felixfisc/SolarSimulator_SOMAP/Result_Data/Spectral_Match/2024-6-5 SpMis rast Halog/1 SpMis rast Halog/about.txt

nd + LP780 on thor @ 35ms with factor *0.25 as used for main maximum of halogen lamp
rasterd with 9x9 points 1cm steps
measurement devices were centered on main maximum at start (X = 40 cm, Y = 40 cm)
