felixfisc/SolarSimulator_SOMAP/Result_Data/Spectral_Match/1 Halogen main + sidemax/Figure_1_halogen_mainmax_24mm_35ms.png

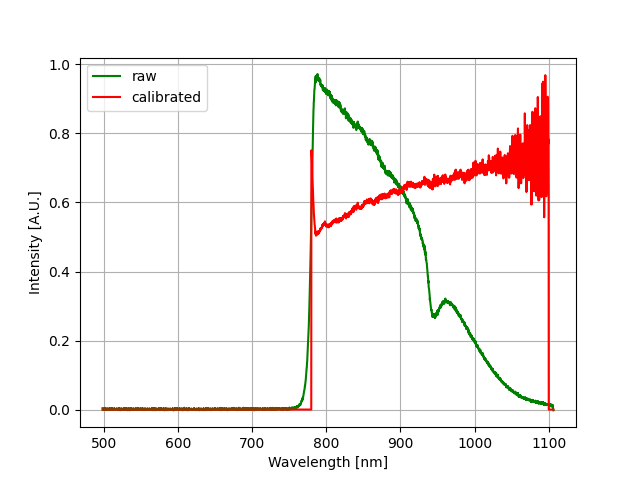
Result_Data/Spectral_Match/1 Halogen main + sidemax/Figure_1_halogen_mainmax_24mm_35ms.png
