felixfisc/SolarSimulator_SOMAP/PCBs_KiCad/Parts_KiCad/LIB_A6211GLJTR-T/A6211GLJTR-T/3D/A6211GLJTR-T.stp

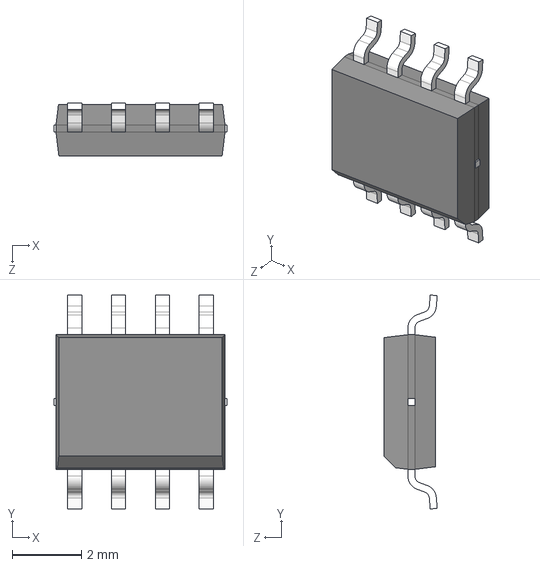
[picture p3: CAD file, 2024-07-03]
PCBs_KiCad/Parts_KiCad/LIB_A6211GLJTR-T/A6211GLJTR-T/3D/A6211GLJTR-T.stp
5.00 x 6.20 x 1.55 mm
