felixfisc/SolarSimulator_SOMAP/PCBs_KiCad/Parts_KiCad/LIB_B250A-13-F/B250A-13-F/3D/B250A-13-F.stp

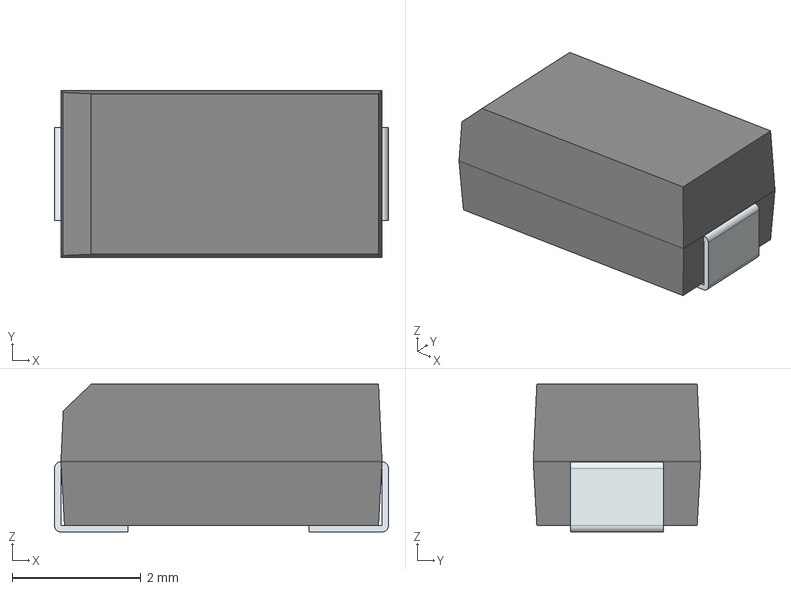
[picture p4: CAD file, 2024-07-03]
PCBs_KiCad/Parts_KiCad/LIB_B250A-13-F/B250A-13-F/3D/B250A-13-F.stp
5.20 x 2.60 x 2.30 mm
FilletPin1
FilletPin2
