felixfisc/SolarSimulator_SOMAP/PCBs_KiCad/Parts_KiCad/LIB_ERJ-U6SFR10V/ERJ-U6SFR10V/3D/ERJ-U6SFR10V.stp

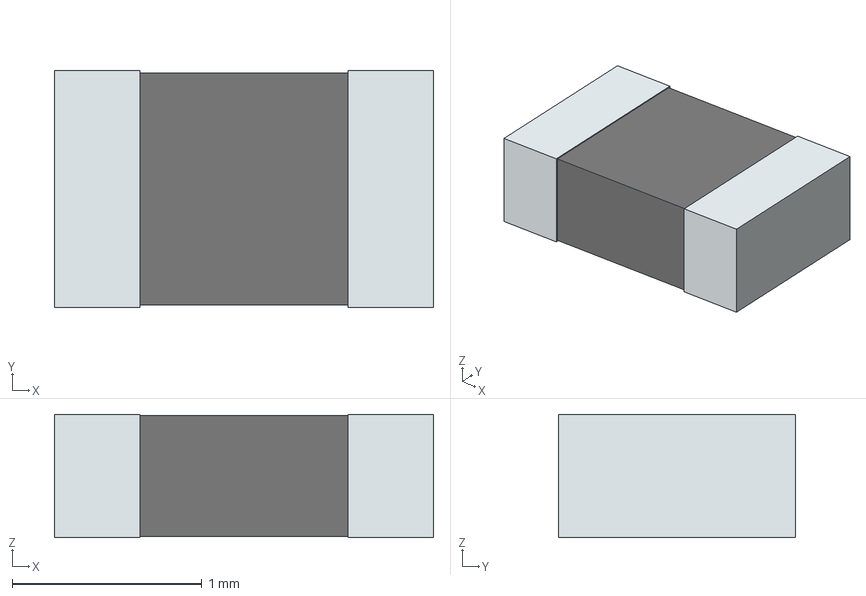
[picture p5: CAD file, 2024-07-03]
PCBs_KiCad/Parts_KiCad/LIB_ERJ-U6SFR10V/ERJ-U6SFR10V/3D/ERJ-U6SFR10V.stp
2.00 x 1.25 x 0.65 mm
term1
term2
