felixfisc/SolarSimulator_SOMAP/PCBs_KiCad/Parts_KiCad/LIB_SRR1210-680M/SRR1210-680M/3D/SRR1210-680M.stp

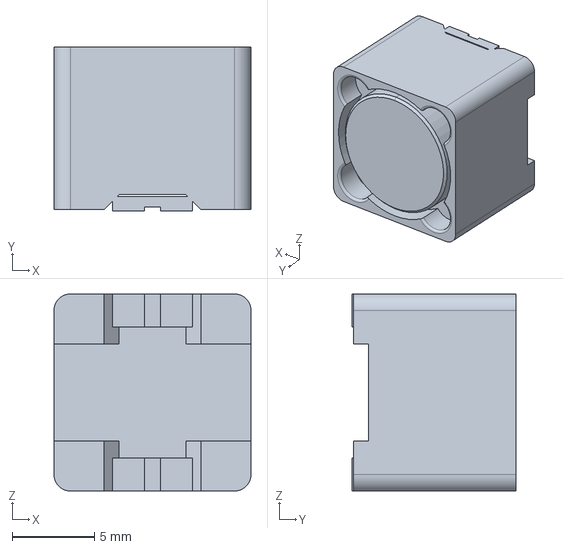
[picture p6: CAD file, 2024-07-03]
PCBs_KiCad/Parts_KiCad/LIB_SRR1210-680M/SRR1210-680M/3D/SRR1210-680M.stp
12.0 x 10.0 x 12.0 mm
