felixfisc/SolarSimulator_SOMAP/PCBs_KiCad/Parts_KiCad/43650-1021/3D/43650-1021.stp

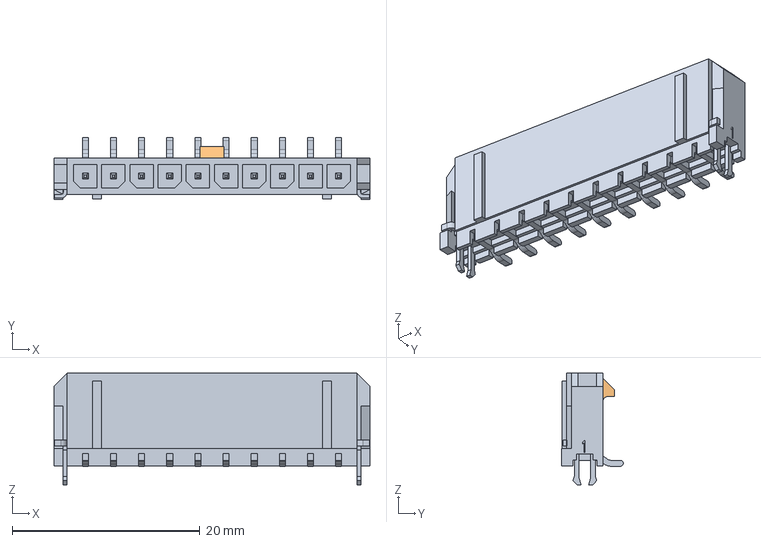
[picture p7: CAD file, 2024-07-03]
PCBs_KiCad/Parts_KiCad/43650-1021/3D/43650-1021.stp
33.7 x 6.57 x 11.9 mm
