felixfisc/SolarSimulator_SOMAP/PCBs_KiCad/Parts_KiCad/LIB_43650-0212/43650-0212/3D/43650-0212.stp

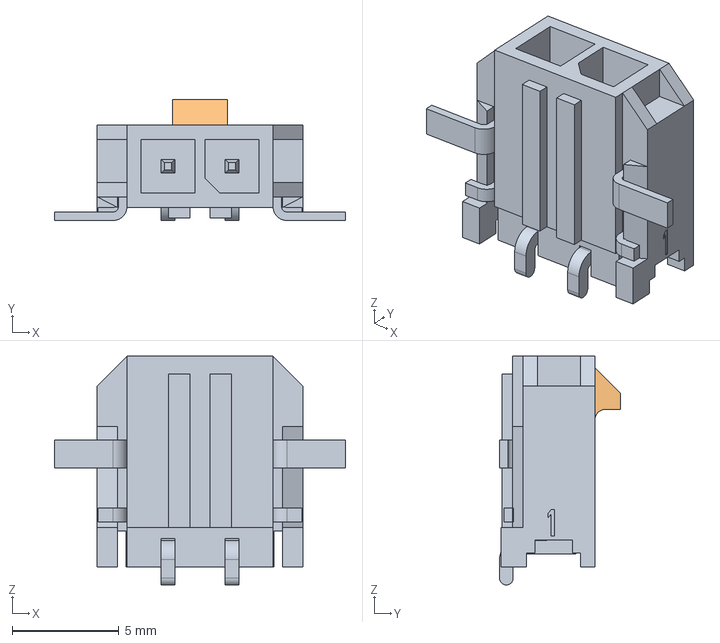
[picture p8: CAD file, 2024-07-03]
PCBs_KiCad/Parts_KiCad/LIB_43650-0212/43650-0212/3D/43650-0212.stp
13.7 x 5.67 x 10.7 mm
