felixfisc/SolarSimulator_SOMAP/PCBs_KiCad/Parts_KiCad/LIB_43650-0500/43650-0500/3D/43650-0500.stp

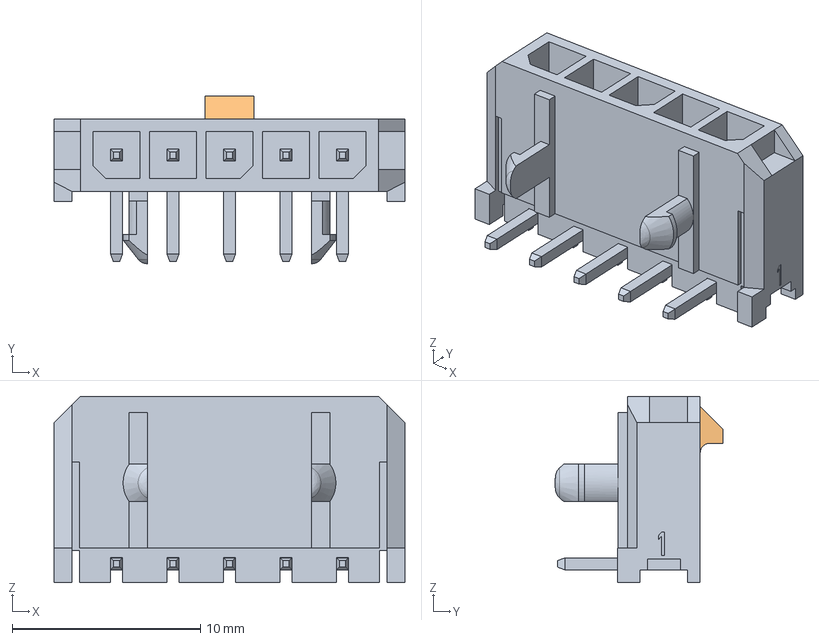
[picture p9: CAD file, 2024-07-03]
PCBs_KiCad/Parts_KiCad/LIB_43650-0500/43650-0500/3D/43650-0500.stp
18.6 x 8.91 x 9.90 mm
