felixfisc/SolarSimulator_SOMAP/PCBs_KiCad/Parts_KiCad/LIB_43650-0600/43650-0600/3D/43650-0600.stp

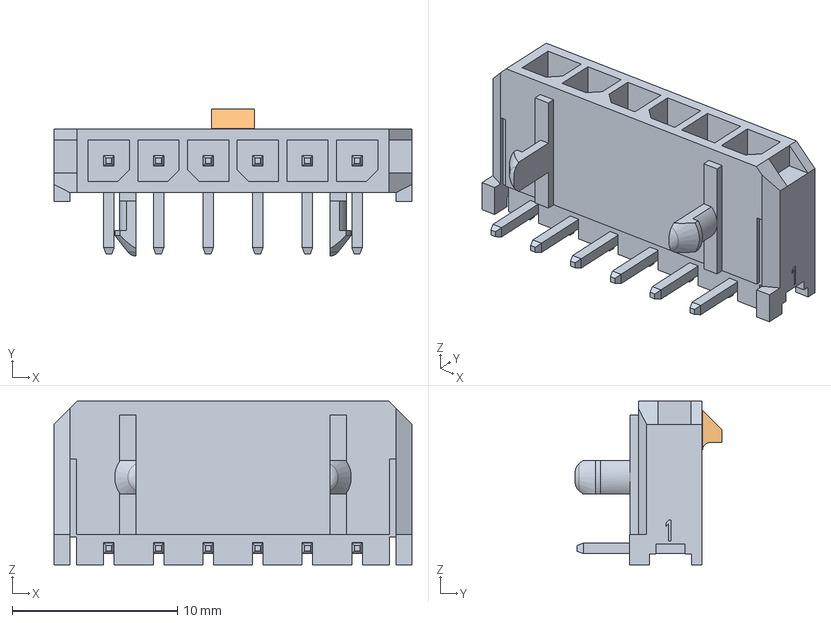
[picture p10: CAD file, 2024-07-03]
PCBs_KiCad/Parts_KiCad/LIB_43650-0600/43650-0600/3D/43650-0600.stp
21.6 x 8.90 x 9.90 mm
