felixfisc/SolarSimulator_SOMAP/PCBs_KiCad/Parts_KiCad/LIB_436501009/436501009/3D/436501009.stp

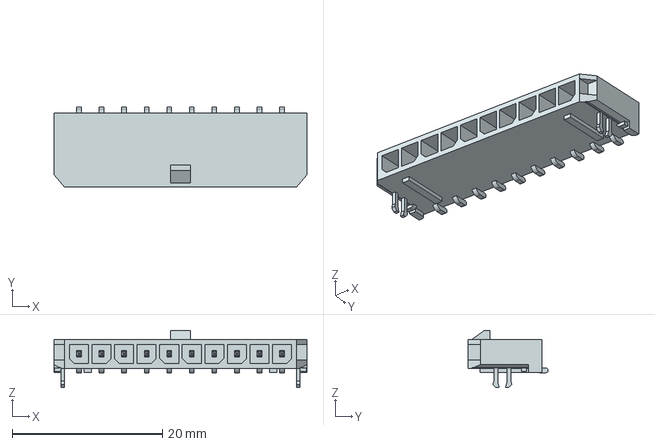
[picture p11: CAD file, 2024-07-03]
PCBs_KiCad/Parts_KiCad/LIB_436501009/436501009/3D/436501009.stp
33.7 x 10.7 x 7.60 mm
