felixfisc/SolarSimulator_SOMAP/PCBs_KiCad/Parts_KiCad/LIB_MP24833-AGN-Z/MP24833-AGN-Z/3D/MP24833-AGN-Z.stp

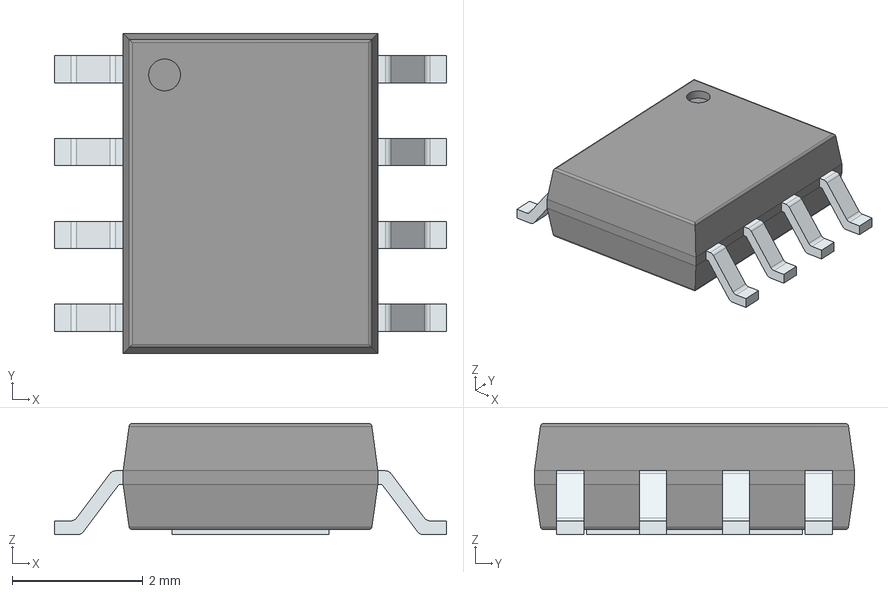
[picture p12: CAD file, 2024-07-03]
PCBs_KiCad/Parts_KiCad/LIB_MP24833-AGN-Z/MP24833-AGN-Z/3D/MP24833-AGN-Z.stp
6.00 x 4.90 x 1.70 mm
PinsArrayLR
ThermalPad
