felixfisc/SolarSimulator_SOMAP/(list of files, cad)

Other CAD files:
PCBs_KiCad/Parts_KiCad/43650-1021/Allegro/43650-10yy_212223.psm
PCBs_KiCad/Parts_KiCad/43650-1021/DEHDL/43650_1021/chips/chips.prt
PCBs_KiCad/Parts_KiCad/LIB_43650-0212/43650-0212/Allegro/43650-02_12,13,14_.psm
PCBs_KiCad/Parts_KiCad/LIB_43650-0212/43650-0212/DEHDL/43650_0212/chips/chips.prt
PCBs_KiCad/Parts_KiCad/LIB_43650-0500/43650-0500/Allegro/43650-05_00,01,02_.psm
PCBs_KiCad/Parts_KiCad/LIB_43650-0500/43650-0500/DEHDL/43650_0500/chips/chips.prt
PCBs_KiCad/Parts_KiCad/LIB_43650-0600/43650-0600/Allegro/43650-06_00,01,02_.psm
PCBs_KiCad/Parts_KiCad/LIB_43650-0600/43650-0600/DEHDL/43650_0600/chips/chips.prt
PCBs_KiCad/Parts_KiCad/LIB_436501009/436501009/Allegro/4365010yy_091011.psm
PCBs_KiCad/Parts_KiCad/LIB_436501009/436501009/DEHDL/436501009/chips/chips.prt
PCBs_KiCad/Parts_KiCad/LIB_A6211GLJTR-T/A6211GLJTR-T/Allegro/soic127p600x170-9n.psm
PCBs_KiCad/Parts_KiCad/LIB_A6211GLJTR-T/A6211GLJTR-T/DEHDL/a6211gljtr_t/chips/chips.prt
PCBs_KiCad/Parts_KiCad/LIB_B250A-13-F/B250A-13-F/Allegro/diom5226x230n.psm
PCBs_KiCad/Parts_KiCad/LIB_B250A-13-F/B250A-13-F/DEHDL/b250a_13_f/chips/chips.prt
PCBs_KiCad/Parts_KiCad/LIB_ERJ-U6SFR10V/ERJ-U6SFR10V/Allegro/resc2012x65n.psm
PCBs_KiCad/Parts_KiCad/LIB_ERJ-U6SFR10V/ERJ-U6SFR10V/DEHDL/erj_u6sfr10v/chips/chips.prt
PCBs_KiCad/Parts_KiCad/LIB_L1HX-5070200000000/L1HX-5070200000000/Allegro/l1hx5070200000000.psm
PCBs_KiCad/Parts_KiCad/LIB_L1HX-5070200000000/L1HX-5070200000000/DEHDL/l1hx_5070200000000/chips/chips.prt
PCBs_KiCad/Parts_KiCad/LIB_LTPL-C034UVH405/LTPL-C034UVH405/Allegro/ltplc034uvh405.psm
PCBs_KiCad/Parts_KiCad/LIB_LTPL-C034UVH405/LTPL-C034UVH405/DEHDL/ltpl_c034uvh405/chips/chips.prt
PCBs_KiCad/Parts_KiCad/LIB_MP24833-AGN-Z/MP24833-AGN-Z/Allegro/soic127p600x170-9n.psm
PCBs_KiCad/Parts_KiCad/LIB_MP24833-AGN-Z/MP24833-AGN-Z/DEHDL/mp24833_agn_z/chips/chips.prt
PCBs_KiCad/Parts_KiCad/LIB_SFH_4715A/SFH_4715A/Allegro/sfh-4715a.psm
PCBs_KiCad/Parts_KiCad/LIB_SFH_4715A/SFH_4715A/DEHDL/sfh_4715a/chips/chips.prt
PCBs_KiCad/Parts_KiCad/LIB_SRR1210-680M/SRR1210-680M/Allegro/srr1210.psm
PCBs_KiCad/Parts_KiCad/LIB_SRR1210-680M/SRR1210-680M/DEHDL/srr1210_680m/chips/chips.prt
PCBs_KiCad/Parts_KiCad/LIB_SST-10-FR-B130-J730/SST-10-FR-B130-J730/Allegro/sst10frb130j730.psm
PCBs_KiCad/Parts_KiCad/LIB_SST-10-FR-B130-J730/SST-10-FR-B130-J730/DEHDL/sst_10_fr_b130_j730/chips/chips.prt
PCBs_KiCad/Parts_KiCad/LIB_SST-20-WDS-A120-L2571/SST-20-WDS-A120-L2571/Allegro/sst20wdsa120l2571.psm
PCBs_KiCad/Parts_KiCad/LIB_SST-20-WDS-A120-L2571/SST-20-WDS-A120-L2571/DEHDL/sst_20_wds_a120_l2571/chips/chips.prt
