felixfisc/SolarSimulator_SOMAP/Result_Data/Non-uniformity/2024-5-22 SolSim/1 SolSim/about.txt

main meas is 12-40-35_15x15
row y = 120 mm row is without diffusor plate on x = 0 - x = 70 mm

additional meas is 13-10-59_15x1
is corrected row y = 120 from main meas, with diffusor plate

startup time of lamp more than 10 min (estimated)
