felixfisc/SolarSimulator_SOMAP/Result_Data/Non-uniformity/2024-5-22 SolSim/12-40-35_15x15_h40_HoMea.pdf

140

0

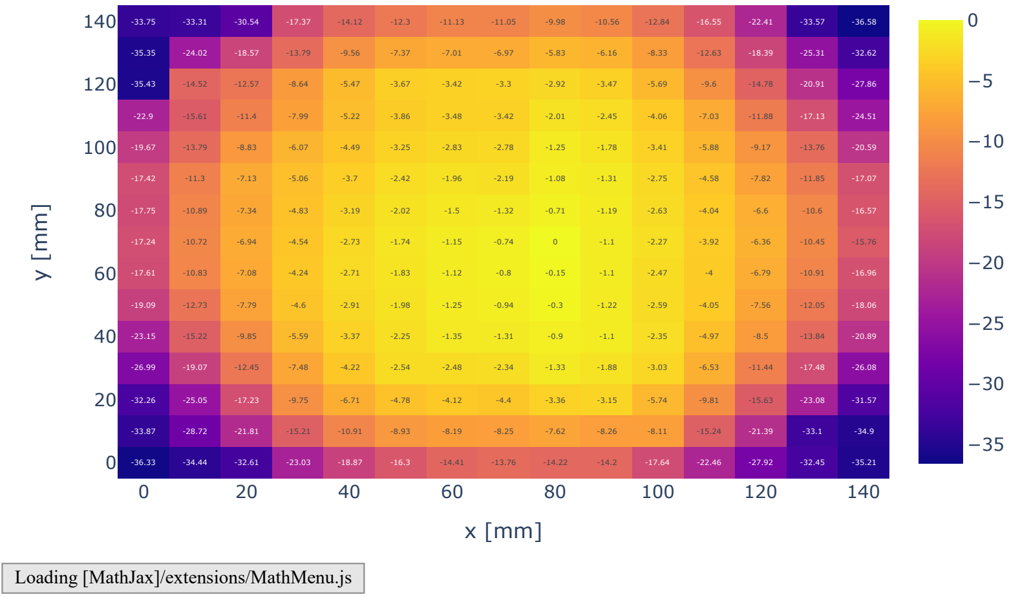
[picture p13: page 1]

-36.33 | -34.44 | -32.61 | -23.03 | -18.87 | -16.3 | -14.41 | -13.76 | -14.22 | -14.2 | -17.64 | -22.46 | -27.92 | -32.45 | -35.21
-33.87 | -28.72 | -21.81 | -15.21 | -10.91 | -8.93 | -8.19 | -8.25 | -7.62 | -8.26 | -8.11 | -15.24 | -21.39 | -33.1 | -34.9
-32.26 | -25.05 | -17.23 | -9.75 | -6.71 | -4.78 | -4.12 | -4.4 | -3.36 | -3.15 | -5.74 | -9.81 | -15.63 | -23.08 | -31.57
-26.99 | -19.07 | -12.45 | -7.48 | -4.22 | -2.54 | -2.48 | -2.34 | -1.33 | -1.88 | -3.03 | -6.53 | -11.44 | -17.48 | -26.08
-23.15 | -15.22 | -9.85 | -5.59 | -3.37 | -2.25 | -1.35 | -1.31 | -0.9 | -1.1 | -2.35 | -4.97 | -8.5 | -13.84 | -20.89
-19.09 | -12.73 | -7.79 | -4.6 | -2.91 | -1.98 | -1.25 | -0.94 | -0.3 | -1.22 | -2.59 | -4.05 | -7.56 | -12.05 | -18.06
-17.61 | -10.83 | -7.08 | -4.24 | -2.71 | -1.83 | -1.12 | -0.8 | -0.15 | -1.1 | -2.47 | -4 | -6.79 | -10.91 | -16.96
-17.24 | -10.72 | -6.94 | -4.54 | -2.73 | -1.74 | -1.15 | -0.74 | 0 | -1.1 | -2.27 | -3.92 | -6.36 | -10.45 | -15.76
-17.75 | -10.89 | -7.34 | -4.83 | -3.19 | -2.02 | -1.5 | -1.32 | -0.71 | -1.19 | -2.63 | -4.04 | -6.6 | -10.6 | -16.57
-17.42 | -11.3 | -7.13 | -5.06 | -3.7 | -2.42 | -1.96 | -2.19 | -1.08 | -1.31 | -2.75 | -4.58 | -7.82 | -11.85 | -17.07
-19.67 | -13.79 | -8.83 | -6.07 | -4.49 | -3.25 | -2.83 | -2.78 | -1.25 | -1.78 | -3.41 | -5.88 | -9.17 | -13.76 | -20.59
-22.9 | -15.61 | -11.4 | -7.99 | -5.22 | -3.86 | -3.48 | -3.42 | -2.01 | -2.45 | -4.06 | -7.03 | -11.88 | -17.13 | -24.51
-35.43 | -14.52 | -12.57 | -8.64 | -5.47 | -3.67 | -3.42 | -3.3 | -2.92 | -3.47 | -5.69 | -9.6 | -14.78 | -20.91 | -27.86
-35.35 | -24.02 | -18.57 | -13.79 | -9.56 | -7.37 | -7.01 | -6.97 | -5.83 | -6.16 | -8.33 | -12.63 | -18.39 | -25.31 | -32.62
-33.75 | -33.31 | -30.54 | -17.37 | -14.12 | -12.3 | -11.13 | -11.05 | -9.98 | -10.56 | -12.84 | -16.55 | -22.41 | -33.57 | -36.58
0 | 20 | 40 | 60 | 80 | 100 | 120 | 140

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
# x [mm]

# y [mm]

# Loading [MathJax]/extensions/MathMenu.js
