felixfisc/SolarSimulator_SOMAP/Result_Data/Non-uniformity/2024-5-23 halog/9-55-6_15x15_h24_HoMea.pdf

140

0

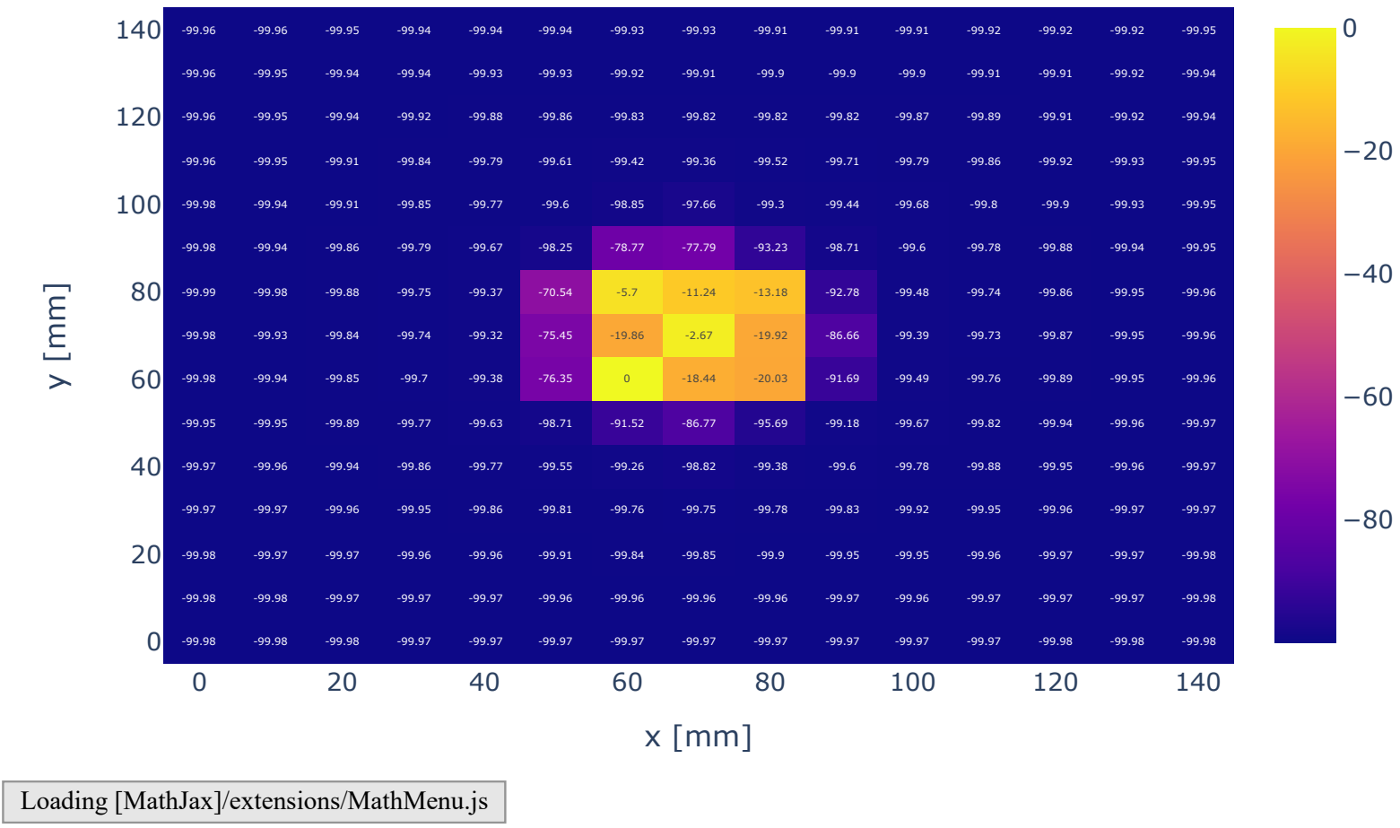
[picture p14: page 1]

-99.98 | -99.98 | -99.98 | -99.97 | -99.97 | -99.97 | -99.97 | -99.97 | -99.97 | -99.97 | -99.97 | -99.97 | -99.98 | -99.98 | -99.98
-99.98 | -99.98 | -99.97 | -99.97 | -99.97 | -99.96 | -99.96 | -99.96 | -99.96 | -99.97 | -99.96 | -99.97 | -99.97 | -99.97 | -99.98
-99.98 | -99.97 | -99.97 | -99.96 | -99.96 | -99.91 | -99.84 | -99.85 | -99.9 | -99.95 | -99.95 | -99.96 | -99.97 | -99.97 | -99.98
-99.97 | -99.97 | -99.96 | -99.95 | -99.86 | -99.81 | -99.76 | -99.75 | -99.78 | -99.83 | -99.92 | -99.95 | -99.96 | -99.97 | -99.97
-99.97 | -99.96 | -99.94 | -99.86 | -99.77 | -99.55 | -99.26 | -98.82 | -99.38 | -99.6 | -99.78 | -99.88 | -99.95 | -99.96 | -99.97
-99.95 | -99.95 | -99.89 | -99.77 | -99.63 | -98.71 | -91.52 | -86.77 | -95.69 | -99.18 | -99.67 | -99.82 | -99.94 | -99.96 | -99.97
-99.98 | -99.94 | -99.85 | -99.7 | -99.38 | -76.35 | 0 | -18.44 | -20.03 | -91.69 | -99.49 | -99.76 | -99.89 | -99.95 | -99.96
-99.98 | -99.93 | -99.84 | -99.74 | -99.32 | -75.45 | -19.86 | -2.67 | -19.92 | -86.66 | -99.39 | -99.73 | -99.87 | -99.95 | -99.96
-99.99 | -99.98 | -99.88 | -99.75 | -99.37 | -70.54 | -5.7 | -11.24 | -13.18 | -92.78 | -99.48 | -99.74 | -99.86 | -99.95 | -99.96
-99.98 | -99.94 | -99.86 | -99.79 | -99.67 | -98.25 | -78.77 | -77.79 | -93.23 | -98.71 | -99.6 | -99.78 | -99.88 | -99.94 | -99.95
-99.98 | -99.94 | -99.91 | -99.85 | -99.77 | -99.6 | -98.85 | -97.66 | -99.3 | -99.44 | -99.68 | -99.8 | -99.9 | -99.93 | -99.95
-99.96 | -99.95 | -99.91 | -99.84 | -99.79 | -99.61 | -99.42 | -99.36 | -99.52 | -99.71 | -99.79 | -99.86 | -99.92 | -99.93 | -99.95
-99.96 | -99.95 | -99.94 | -99.92 | -99.88 | -99.86 | -99.83 | -99.82 | -99.82 | -99.82 | -99.87 | -99.89 | -99.91 | -99.92 | -99.94
-99.96 | -99.95 | -99.94 | -99.94 | -99.93 | -99.93 | -99.92 | -99.91 | -99.9 | -99.9 | -99.9 | -99.91 | -99.91 | -99.92 | -99.94
-99.96 | -99.96 | -99.95 | -99.94 | -99.94 | -99.94 | -99.93 | -99.93 | -99.91 | -99.91 | -99.91 | -99.92 | -99.92 | -99.92 | -99.95
0 | 20 | 40 | 60 | 80 | 100 | 120 | 140

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
# x [mm]

# y [mm]

# Loading [MathJax]/extensions/MathMenu.js
