felixfisc/SolarSimulator_SOMAP/Result_Data/Temporal_Instability/2024-5-23 STI halog/10-51-32_for_10every0.1_TempMea.pdf

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

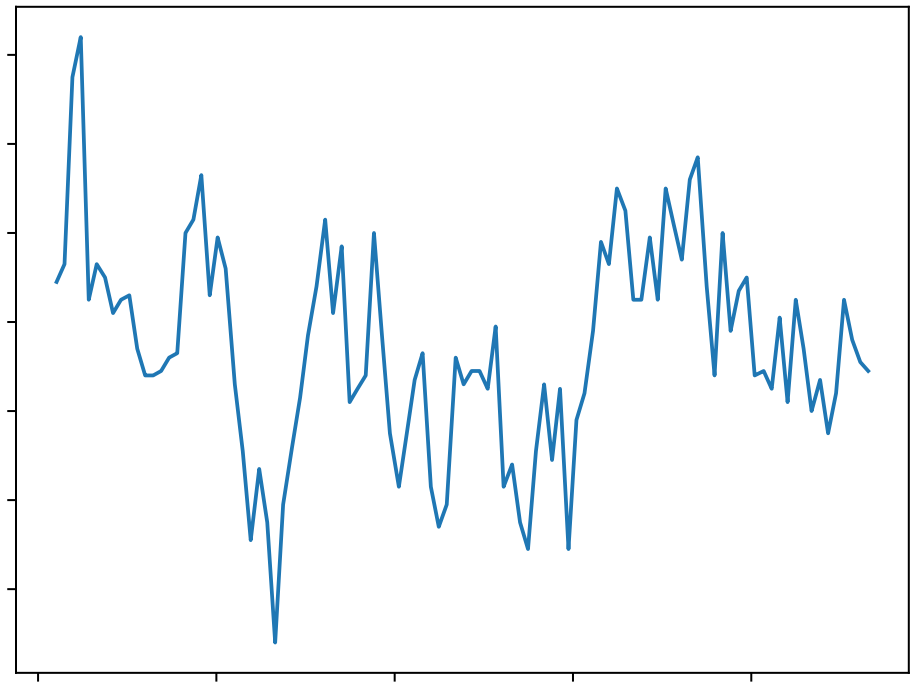
[picture p15: figure]
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
