felixfisc/SolarSimulator_SOMAP/Result_Data/Temporal_Instability/2024-6-4 STI solarsim/13-49-20_for_10every0.1_TempMea.pdf

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

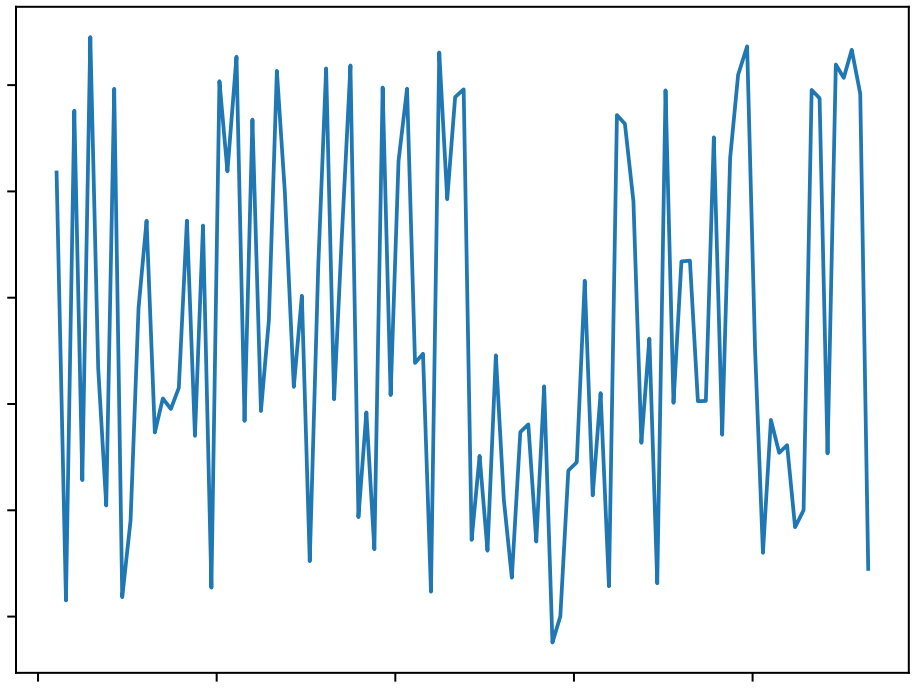
[picture p16: figure]
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
