felixfisc/SolarSimulator_SOMAP/Result_Data/Non-uniformity/2024-5-22 SolSim/12-40-35_15x15_h40_HoMea.csv

Time [s] | x [mm] | y [mm] | Voltage [V] | Current [A]
5.040374400035944 | 0.0 | 0.0 | 0.0 | 8.367719e-05
8.95728400000371 | 10.0 | 0.0 | 0.0 | 8.736299e-05
12.295825299981516 | 20.0 | 0.0 | 0.0 | 9.104525e-05
18.664744500012603 | 30.0 | 0.0 | 0.0 | 0.000112088
21.90893189999042 | 40.0 | 0.0 | 0.0 | 0.0001222832
25.817261299991515 | 50.0 | 0.0 | 0.0 | 0.0001289445
28.99539180001011 | 60.0 | 0.0 | 0.0 | 0.000134038
35.88003860000754 | 70.0 | 0.0 | 0.0 | 0.0001358273
45.687402300012764 | 80.0 | 0.0 | 0.0 | 0.0001345389
54.54699010000331 | 90.0 | 0.0 | 0.0 | 0.0001345979
58.23878950002836 | 100.0 | 0.0 | 0.0 | 0.0001254263
61.129991699999664 | 110.0 | 0.0 | 0.0 | 0.0001134476
64.229378500022 | 120.0 | 0.0 | 0.0 | 0.0001009521
68.35916789999465 | 130.0 | 0.0 | 0.0 | 9.13655e-05
76.70688660000451 | 140.0 | 0.0 | 0.0 | 8.584867e-05
95.10811400000239 | 0.0 | 10.0 | 0.0 | 8.849316e-05
98.49417940003332 | 10.0 | 10.0 | 0.0 | 9.920244e-05
105.84595779998926 | 20.0 | 10.0 | 0.0 | 0.0001149924
108.61865850002505 | 30.0 | 10.0 | 0.0 | 0.0001318502
111.6393875000067 | 40.0 | 10.0 | 0.0 | 0.0001439176
114.49788360000821 | 50.0 | 10.0 | 0.0 | 0.0001497747
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
