felixfisc/SolarSimulator_SOMAP/Result_Data/Non-uniformity/2024-5-23 halog/9-55-6_15x15_h24_HoMea.csv

Time [s] | x [mm] | y [mm] | Voltage [V] | Current [A]
43.01533120003296 | 0.0 | 0.0 | 0.0 | 3.446262e-07
48.76261670002714 | 10.0 | 0.0 | 0.0 | 3.825001e-07
52.681221200036816 | 20.0 | 0.0 | 0.0 | 4.252982e-07
57.439376800030004 | 30.0 | 0.0 | 0.0 | 4.680536e-07
61.81328330002725 | 40.0 | 0.0 | 0.0 | 5.12173e-07
66.13255620002747 | 50.0 | 0.0 | 0.0 | 5.467725e-07
70.4700315000373 | 60.0 | 0.0 | 0.0 | 5.861334e-07
75.19088950002333 | 70.0 | 0.0 | 0.0 | 5.854024e-07
79.34277500002645 | 80.0 | 0.0 | 0.0 | 5.722408e-07
83.96809770003892 | 90.0 | 0.0 | 0.0 | 5.511158e-07
88.15900139999576 | 100.0 | 0.0 | 0.0 | 5.123838e-07
93.96896070003277 | 110.0 | 0.0 | 0.0 | 4.785969e-07
97.49467779998668 | 120.0 | 0.0 | 0.0 | 4.401856e-07
103.35169330000645 | 130.0 | 0.0 | 0.0 | 4.163005e-07
110.20251909998478 | 140.0 | 0.0 | 0.0 | 3.568337e-07
141.12904760002857 | 0.0 | 10.0 | 0.0 | 3.748693e-07
148.30932810000377 | 10.0 | 10.0 | 0.0 | 4.29958e-07
151.95926040003542 | 20.0 | 10.0 | 0.0 | 4.843454e-07
155.76170860003913 | 30.0 | 10.0 | 0.0 | 5.414111e-07
165.12433140003122 | 40.0 | 10.0 | 0.0 | 5.923667e-07
169.29619990003994 | 50.0 | 10.0 | 0.0 | 6.49683e-07
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
