felixfisc/SolarSimulator_SOMAP/Result_Data/Temporal_Instability/2024-5-22 LTI/11-5-57_for_0.5every3600_TempMea.csv

Time [s] | Voltage [V] | Current [A]
0.20884410000871867 | 0.003007493 | 0.0
0.7145357999834232 | 0.001727329 | 0.0
1.2151527000241913 | 0.001724648 | 0.0
1.7148249999736436 | 0.001785547 | 0.0
2.3536745000164956 | 0.7128241 | 0.0
2.8461275000008754 | 1.321521 | 0.0
3.3430979999830015 | 1.30375 | 0.0
3.8469934000167996 | 1.292334 | 0.0
4.337669699976686 | 1.291703 | 0.0
4.840746800007764 | 1.28871 | 0.0
5.331471999990754 | 1.289961 | 0.0
5.834397099970374 | 1.276646 | 0.0
6.338158899976406 | 1.276508 | 0.0
6.841444400022738 | 1.279446 | 0.0
7.344704899995122 | 1.277549 | 0.0
7.852077000017744 | 1.269216 | 0.0
8.354479299974628 | 1.276977 | 0.0
8.858881600026507 | 1.277001 | 0.0
9.36242379999021 | 1.264407 | 0.0
9.895400399982464 | 1.269007 | 0.0
10.400409499998204 | 1.267611 | 0.0
10.903407500009052 | 1.268654 | 0.0
11.40666350000538 | 1.267681 | 0.0
11.9106899999897 | 1.261042 | 0.0
12.414683900016826 | 1.265332 | 0.0
12.9179213999887 | 1.261356 | 0.0
13.42090750002535 | 1.264682 | 0.0
13.924256199970841 | 1.260888 | 0.0
14.428355099982582 | 1.26293 | 0.0
14.93217270000605 | 1.267866 | 0.0
15.43622009997489 | 1.256485 | 0.0
15.939528900024015 | 1.265121 | 0.0
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
