felixfisc/SolarSimulator_SOMAP/Result_Data/Temporal_Instability/2024-5-22 LTI/14-30-18_for_0.5every3600_TempMea.csv

Time [s] | Voltage [V] | Current [A]
0.20634889998473227 | 0.003065498 | 0.0
0.7073240999598056 | 0.00132244 | 0.0
1.2066635999944992 | 0.001440792 | 0.0
1.8413532999693416 | 0.9999832 | 0.0
2.34269989997847 | 1.000039 | 0.0
2.838704299996607 | 1.001119 | 0.0
3.3408000000054017 | 1.000985 | 0.0
3.8425281000090763 | 1.00106 | 0.0
4.344129099976271 | 0.9999552 | 0.0
4.845726199971978 | 0.9999545 | 0.0
5.3473031999892555 | 1.000026 | 0.0
5.848486099974252 | 1.000095 | 0.0
6.349757599993609 | 1.000192 | 0.0
6.851336599967908 | 1.001035 | 0.0
7.352386999991722 | 1.001208 | 0.0
7.854756399989128 | 1.001464 | 0.0
8.3560976999579 | 1.000607 | 0.0
8.856850599986501 | 1.000966 | 0.0
9.35834579996299 | 1.0009 | 0.0
9.859497800003737 | 1.001567 | 0.0
10.360349599970505 | 1.001217 | 0.0
10.862149299995508 | 1.001827 | 0.0
11.363947400008328 | 1.00267 | 0.0
11.865419199981261 | 1.002285 | 0.0
12.366364299959969 | 1.00208 | 0.0
12.866383899992798 | 1.002043 | 0.0
13.367674099979922 | 1.002877 | 0.0
13.869355599978007 | 1.00334 | 0.0
14.37064169999212 | 1.002696 | 0.0
14.871948799991515 | 1.002808 | 0.0
15.373497299966402 | 1.00299 | 0.0
15.875216599961277 | 1.003255 | 0.0
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
