felixfisc/SolarSimulator_SOMAP/Result_Data/Temporal_Instability/2024-5-22 LTI/LTI calc.xlsx

Sheet: SolSim LTI
Time [s] | Voltage [V] | Current [A] | Max | Min | LTI [%] | Start second | Field
0.2088441 | 0.003007493 | 0 | 1.277001 | 1.046692 | 9.911335103 | 8.5 | 18
0.7145358 | 0.001727329 | 0 | 1.203569 | 1.046692 | 6.971502417 | 500 | 990
1.2151527 | 0.001724648 | 0 | 1.203569 | 1.046692 | 6.971502417 | 1000 | 1973
1.714825 | 0.001785547 | 0
2.3536745 | 0.7128241 | 0
2.8461275 | 1.321521 | 0
3.343098 | 1.30375 | 0
3.8469934 | 1.292334 | 0
4.3376697 | 1.291703 | 0
4.8407468 | 1.28871 | 0
5.331472 | 1.289961 | 0
5.8343971 | 1.276646 | 0
6.3381589 | 1.276508 | 0
6.8414444 | 1.279446 | 0
7.3447049 | 1.277549 | 0
7.852077 | 1.269216 | 0
8.3544793 | 1.276977 | 0
8.8588816 | 1.277001 | 0
9.3624238 | 1.264407 | 0
9.8954004 | 1.269007 | 0
10.4004095 | 1.267611 | 0
10.9034075 | 1.268654 | 0
11.4066635 | 1.267681 | 0
11.91069 | 1.261042 | 0
12.4146839 | 1.265332 | 0
12.9179214 | 1.261356 | 0
13.4209075 | 1.264682 | 0
13.9242562 | 1.260888 | 0
14.4283551 | 1.26293 | 0
14.9321727 | 1.267866 | 0
15.4362201 | 1.256485 | 0
15.9395289 | 1.265121 | 0
16.4648084 | 1.263889 | 0
16.9687886 | 1.254592 | 0
17.4735925 | 1.261419 | 0
17.9767794 | 1.257407 | 0
18.4801483 | 1.263244 | 0
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
