felixfisc/SolarSimulator_SOMAP/Result_Data/Temporal_Instability/2024-5-23 STI halog/10-51-32_for_10every0.1_TempMea.csv

Time [s] | Voltage [V] | Current [A]
0.20766349998302758 | 1.010089 | 0.0
0.2966718999668956 | 1.010093 | 0.0
0.3854058000142686 | 1.010135 | 0.0
0.4787699999869801 | 1.010144 | 0.0
0.5684926999965683 | 1.010085 | 0.0
0.6578878000145778 | 1.010093 | 0.0
0.751289599982556 | 1.01009 | 0.0
0.8409976999973878 | 1.010082 | 0.0
0.9305459999595769 | 1.010085 | 0.0
1.0235560999717563 | 1.010086 | 0.0
1.1124842999852262 | 1.010074 | 0.0
1.2012970999930985 | 1.010068 | 0.0
1.2908079999615438 | 1.010068 | 0.0
1.380336800008081 | 1.010069 | 0.0
1.4699872999917716 | 1.010072 | 0.0
1.5610102000064217 | 1.010073 | 0.0
1.6535248999716714 | 1.0101 | 0.0
1.7423499000142328 | 1.010103 | 0.0
1.8313868999830447 | 1.010113 | 0.0
1.925538300012704 | 1.010086 | 0.0
2.0142856999882497 | 1.010099 | 0.0
2.104157399968244 | 1.010092 | 0.0
2.206815399986226 | 1.010066 | 0.0
2.295910399989225 | 1.010051 | 0.0
2.3852410999825224 | 1.010031 | 0.0
2.4803532999940217 | 1.010047 | 0.0
2.570690599968657 | 1.010035 | 0.0
2.6595051999902353 | 1.010008 | 0.0
2.7487952999654226 | 1.010039 | 0.0
2.8498966000042856 | 1.010052 | 0.0
2.9389879999798723 | 1.010063 | 0.0
3.02745930000674 | 1.010077 | 0.0
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
