felixfisc/SolarSimulator_SOMAP/Result_Data/Temporal_Instability/2024-5-23 STI halog/10-51-32_for_10every0.1_TempMea_STI_halog_calc.csv

Time [s] | Voltage [V] | Current [A] | Temporal Instability (STI) [%]
0.20766349998302758 | 1.010089 | 0.0
0.2966718999668956 | 1.010093 | 0.0 | 0.000198001962194
0.3854058000142686 | 1.010135 | 0.0 | 0.002078973264409
0.4787699999869801 | 1.010144 | 0.0 | 0.000445483024866
0.5684926999965683 | 1.010085 | 0.0 | 0.002920460997245
0.6578878000145778 | 1.010093 | 0.0 | 0.000396004708496
0.751289599982556 | 1.01009 | 0.0 | 0.000148501398139
0.8409976999973878 | 1.010082 | 0.0 | 0.000396005884648
0.9305459999595769 | 1.010085 | 0.0 | 0.000148502574291
1.0235560999717563 | 1.010086 | 0.0 | 4.95007600910902E-05
1.1124842999852262 | 1.010074 | 0.0 | 0.000594012355463
1.2012970999930985 | 1.010068 | 0.0 | 0.00029700882413
1.2908079999615438 | 1.010068 | 0.0 | 0
1.380336800008081 | 1.010069 | 0.0 | 4.95015932156967E-05
1.4699872999917716 | 1.010072 | 0.0 | 0.000148504485577
1.5610102000064217 | 1.010073 | 0.0 | 4.9501397172863E-05
1.6535248999716714 | 1.0101 | 0.0 | 0.001336519199098
1.7423499000142328 | 1.010103 | 0.0 | 0.000148499927976
1.8313868999830447 | 1.010113 | 0.0 | 0.000494996574627
1.925538300012704 | 1.010086 | 0.0 | 0.00133650199807
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
