felixfisc/SolarSimulator_SOMAP/Result_Data/Temporal_Instability/2024-6-4 STI solarsim/13-49-20_for_10every0.1_TempMea.csv

Time [s] | Voltage [V] | Current [A]
0.20764300000155345 | 1.232356 | 0.0
0.31260570000085863 | 1.224303 | 0.0
0.4060978999987128 | 1.233519 | 0.0
0.4956455999999889 | 1.226567 | 0.0
0.5852602000013576 | 1.234904 | 0.0
0.6735164999990957 | 1.228676 | 0.0
0.7635942999986582 | 1.226089 | 0.0
0.8528194999998959 | 1.233931 | 0.0
0.942564199998742 | 1.224364 | 0.0
1.0359759999992093 | 1.225808 | 0.0
1.1252287999996042 | 1.229806 | 0.0
1.215241199999582 | 1.231449 | 0.0
1.3075538000011875 | 1.227464 | 0.0
1.397334099998261 | 1.228105 | 0.0
1.4869891999987885 | 1.227906 | 0.0
1.5759839999991527 | 1.228303 | 0.0
1.6669170999994094 | 1.231451 | 0.0
1.756802100000641 | 1.2274 | 0.0
1.8469500999999582 | 1.231358 | 0.0
1.9409677000003285 | 1.224544 | 0.0
2.030882200000633 | 1.234074 | 0.0
2.1203616999991937 | 1.232377 | 0.0
2.2218610999989323 | 1.234535 | 0.0
2.3120392999990145 | 1.227682 | 0.0
2.400383600001078 | 1.233351 | 0.0
2.4955673000004026 | 1.227867 | 0.0
2.5845907000002626 | 1.22958 | 0.0
2.673874699998123 | 1.234268 | 0.0
2.7630171999990125 | 1.231992 | 0.0
2.863593400001264 | 1.228321 | 0.0
2.953713200000493 | 1.230037 | 0.0
3.0419656999984 | 1.225043 | 0.0
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
