felixfisc/SolarSimulator_SOMAP/Result_Data/Temporal_Instability/2024-6-4 STI solarsim/13-49-20_for_10every0.1_TempMea_calc.csv

Time [s] | Voltage [V] | Current [A] | STI [%]
0.20764300000155345 | 1.232356 | 0.0
0.31260570000085863 | 1.224303 | 0.0 | 0.327802922587143
0.4060978999987128 | 1.233519 | 0.0 | 0.374966128547963
0.4956455999999889 | 1.226567 | 0.0 | 0.282591746792595
0.5852602000013576 | 1.234904 | 0.0 | 0.338699907494341
0.6735164999990957 | 1.228676 | 0.0 | 0.252802831651495
0.7635942999986582 | 1.226089 | 0.0 | 0.10538687002626
0.8528194999998959 | 1.233931 | 0.0 | 0.318777896114662
0.942564199998742 | 1.224364 | 0.0 | 0.389172170142309
1.0359759999992093 | 1.225808 | 0.0 | 0.058934638058063
1.1252287999996042 | 1.229806 | 0.0 | 0.162810604598278
1.215241199999582 | 1.231449 | 0.0 | 0.066754562205056
1.3075538000011875 | 1.227464 | 0.0 | 0.162063480895823
1.397334099998261 | 1.228105 | 0.0 | 0.026103929476219
1.4869891999987885 | 1.227906 | 0.0 | 0.008102569573184
1.5759839999991527 | 1.228303 | 0.0 | 0.016163119669376
1.6669170999994094 | 1.231451 | 0.0 | 0.127980277702573
1.756802100000641 | 1.2274 | 0.0 | 0.164751747869229
1.8469500999999582 | 1.231358 | 0.0 | 0.160975581980817
1.9409677000003285 | 1.224544 | 0.0 | 0.277454067792602
2.030882200000633 | 1.234074 | 0.0 | 0.387616132314976
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
