felixfisc/SolarSimulator_SOMAP/Result_Data/Temporal_Instability/2024-5-22 LTI/14-30-18_for_0.5every3600_TempMea.pdf

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

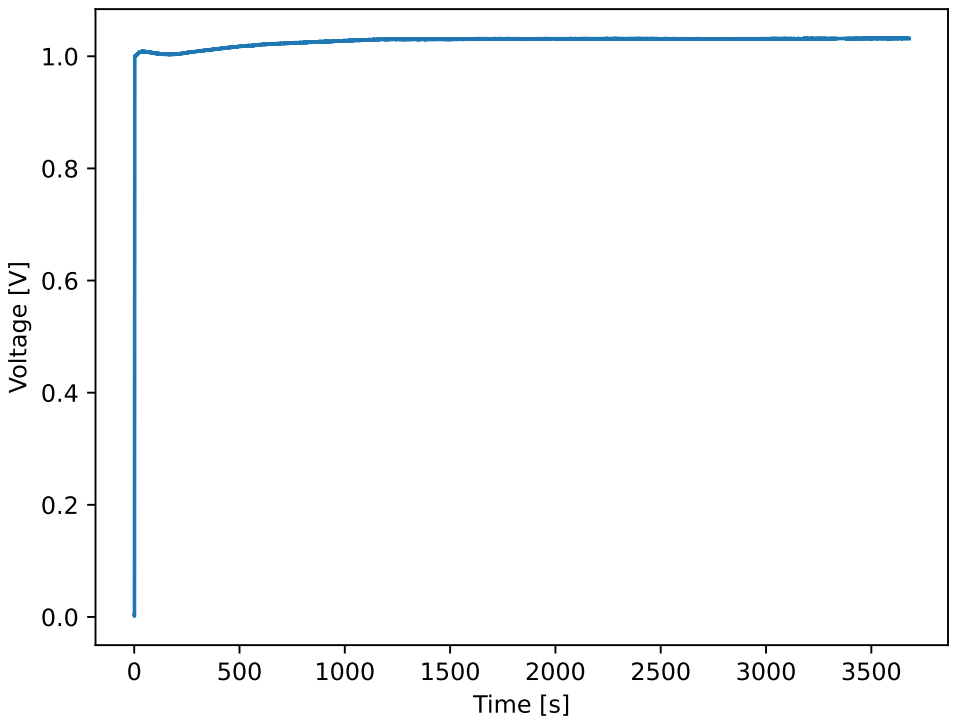
[picture p18: page 1]
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
