felixfisc/SolarSimulator_SOMAP/(list of files, drawings)

Other design files:
PCBs_KiCad/Parts_KiCad/LIB_A6211GLJTR-T/A6211GLJTR-T/Altium/A6211GLJTR-T.SchLib
PCBs_KiCad/Parts_KiCad/LIB_A6211GLJTR-T/A6211GLJTR-T/Altium/SOIC127P600X170-9N.PcbLib
PCBs_KiCad/Parts_KiCad/LIB_B250A-13-F/B250A-13-F/Altium/B250A-13-F.SchLib
PCBs_KiCad/Parts_KiCad/LIB_B250A-13-F/B250A-13-F/Altium/DIOM5226X230N.PcbLib
PCBs_KiCad/Parts_KiCad/LIB_ERJ-U6SFR10V/ERJ-U6SFR10V/Altium/ERJ-U6SFR10V.SchLib
PCBs_KiCad/Parts_KiCad/LIB_ERJ-U6SFR10V/ERJ-U6SFR10V/Altium/RESC2012X65N.PcbLib
PCBs_KiCad/Parts_KiCad/LIB_L1HX-5070200000000/L1HX-5070200000000/Altium/L1HX5070200000000.PcbLib
PCBs_KiCad/Parts_KiCad/LIB_L1HX-5070200000000/L1HX-5070200000000/Altium/L1HX-5070200000000.SchLib
PCBs_KiCad/Parts_KiCad/LIB_MP24833-AGN-Z/MP24833-AGN-Z/Altium/MP24833-AGN-Z.SchLib
PCBs_KiCad/Parts_KiCad/LIB_MP24833-AGN-Z/MP24833-AGN-Z/Altium/SOIC127P600X170-9N.PcbLib
PCBs_KiCad/Parts_KiCad/LIB_SST-10-FR-B130-J730/SST-10-FR-B130-J730/Altium/SST10FRB130J730.PcbLib
PCBs_KiCad/Parts_KiCad/LIB_SST-10-FR-B130-J730/SST-10-FR-B130-J730/Altium/SST-10-FR-B130-J730.SchLib
PCBs_KiCad/Parts_KiCad/LIB_SST-20-WDS-A120-L2571/SST-20-WDS-A120-L2571/Altium/SST20WDSA120L2571.PcbLib
PCBs_KiCad/Parts_KiCad/LIB_SST-20-WDS-A120-L2571/SST-20-WDS-A120-L2571/Altium/SST-20-WDS-A120-L2571.SchLib
