felixfisc/SolarSimulator_SOMAP/PCBs_KiCad/Driver/LayoutDriverPCBv2_3.kicad_pcb

## KiCad design PCBs_KiCad/Driver/LayoutDriverPCBv2_3.kicad_pcb (2024-07-03)

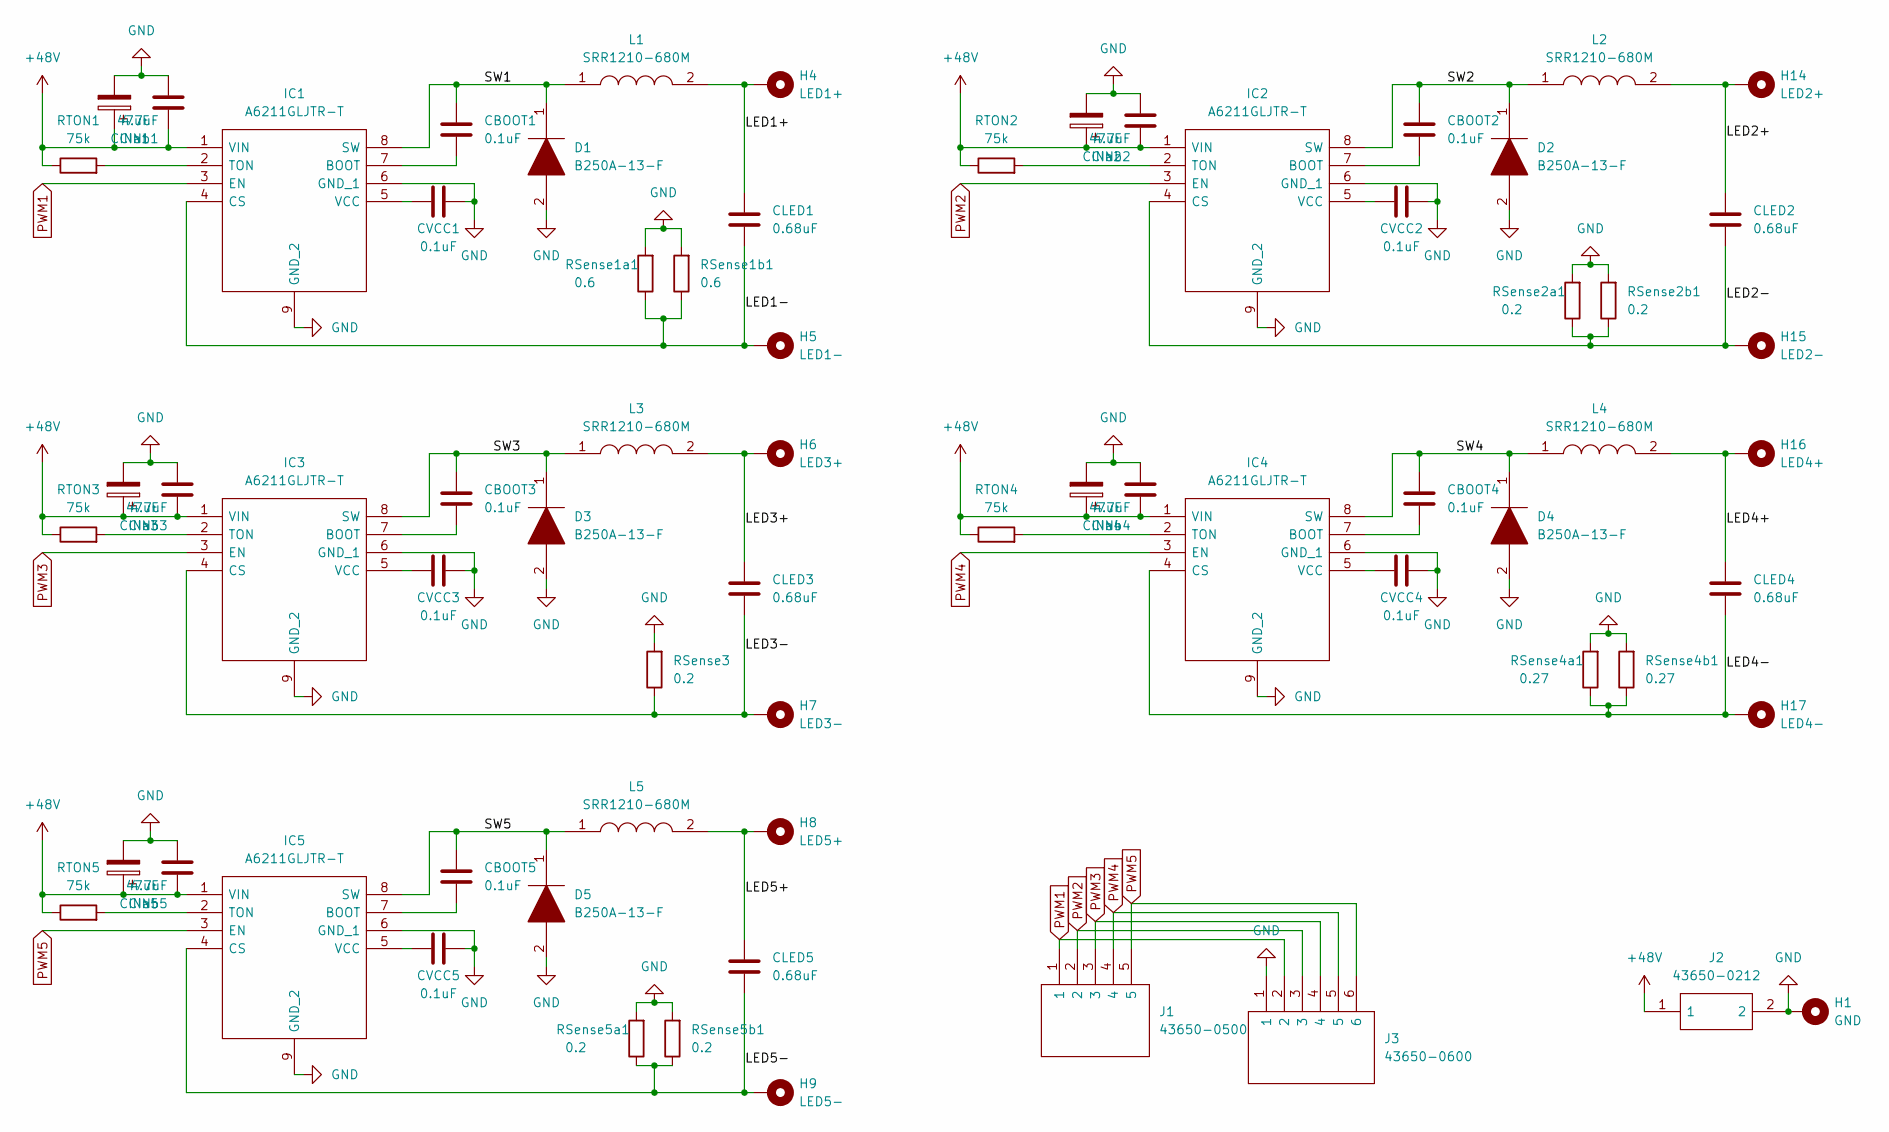
[picture p20: schematic LayoutDriverPCBv2_3.kicad_sch]

Parts:
CBOOT1, CBOOT2, CBOOT3, CBOOT4, CBOOT5: 0.1uF; C_0603_1608Metric
CINa1, CINa2, CINa3, CINa4, CINa5: 47uF; CP_Elec_6.3x5.8
CINb1, CINb2, CINb3, CINb4, CINb5: 4.7uF; C_1210_3225Metric
CLED1, CLED2, CLED3, CLED4, CLED5: 0.68uF; C_1210_3225Metric
CVCC1, CVCC2, CVCC3, CVCC4, CVCC5: 0.1uF; C_0603_1608Metric
D1, D2, D3, D4, D5: B250A-13-F; DIOM5226X230N; Manufacturer_Part_Number B250A-13-F; Mouser Part Number 621-B250A-F
H1: GND; MountingHole_2.2mm_M2_DIN965_Pad
H4: LED1+; MountingHole_2.2mm_M2_DIN965_Pad
H5: LED1-; MountingHole_2.2mm_M2_DIN965_Pad
H6: LED3+; MountingHole_2.2mm_M2_DIN965_Pad
H7: LED3-; MountingHole_2.2mm_M2_DIN965_Pad
H8: LED5+; MountingHole_2.2mm_M2_DIN965_Pad
H9: LED5-; MountingHole_2.2mm_M2_DIN965_Pad
H14: LED2+; MountingHole_2.2mm_M2_DIN965_Pad
H15: LED2-; MountingHole_2.2mm_M2_DIN965_Pad
H16: LED4+; MountingHole_2.2mm_M2_DIN965_Pad
H17: LED4-; MountingHole_2.2mm_M2_DIN965_Pad
IC1, IC2, IC3, IC4, IC5: A6211GLJTR-T; SOIC127P600X170-9N; Manufacturer_Part_Number A6211GLJTR-T; Mouser Part Number 250-A6211GLJTR-T
J1: 43650-0500; Molex_Micro-Fit_3.0_43650-0500_1x05_P3.00mm_Horizontal; Manufacturer_Part_Number 43650-0500; Mouser Part Number 538-43650-0500
J2: 43650-0212; 43650-02_12,13,14_; Manufacturer_Part_Number 43650-0212; Mouser Part Number 538-43650-0212
J3: 43650-0600; Molex_Micro-Fit_3.0_43650-0600_1x06_P3.00mm_Horizontal; Manufacturer_Part_Number 43650-0600; Mouser Part Number 538-43650-0600
L1, L2, L3, L4, L5: SRR1210-680M; SRR1210; Manufacturer_Part_Number SRR1210-680M; Mouser Part Number 652-SRR1210-680M
RSense1a1, RSense1b1: 0.6; R_1812_4532Metric
RSense2a1, RSense2b1, RSense3, RSense5a1, RSense5b1: 0.2; R_0805_2012Metric
RSense4a1, RSense4b1: 0.27; R_0805_2012Metric
RTON1, RTON2, RTON3, RTON4, RTON5: 75k; R_0603_1608Metric

Connections:
+48V: CINa1.1, CINa2.1, CINa3.1, CINa4.1, CINa5.1, CINb1.1, CINb2.1, CINb3.1, CINb4.1, CINb5.1, IC1.1 (VIN), IC2.1 (VIN), IC3.1 (VIN), IC4.1 (VIN), IC5.1 (VIN), J2.1, RTON1.1, RTON2.1, RTON3.1, RTON4.1, RTON5.1
/LED1+: CLED1.1, H4.1, L1.2
/LED1-: CLED1.2, H5.1, IC1.4 (CS), RSense1a1.1, RSense1b1.1
/LED2+: CLED2.1, H14.1, L2.2
/LED2-: CLED2.2, H15.1, IC2.4 (CS), RSense2a1.1, RSense2b1.1
/LED3+: CLED3.1, H6.1, L3.2
/LED3-: CLED3.2, H7.1, IC3.4 (CS), RSense3.1
/LED4+: CLED4.1, H16.1, L4.2
/LED4-: CLED4.2, H17.1, IC4.4 (CS), RSense4a1.1, RSense4b1.1
/LED5+: CLED5.1, H8.1, L5.2
/LED5-: CLED5.2, H9.1, IC5.4 (CS), RSense5a1.1, RSense5b1.1
/SW1: CBOOT1.1, D1.1, IC1.8 (SW), L1.1
/SW2: CBOOT2.1, D2.1, IC2.8 (SW), L2.1
/SW3: CBOOT3.1, D3.1, IC3.8 (SW), L3.1
/SW4: CBOOT4.1, D4.1, IC4.8 (SW), L4.1
/SW5: CBOOT5.1, D5.1, IC5.8 (SW), L5.1
GND: CINa1.2, CINa2.2, CINa3.2, CINa4.2, CINa5.2, CINb1.2, CINb2.2, CINb3.2, CINb4.2, CINb5.2, CVCC1.2, CVCC2.2, CVCC3.2, CVCC4.2, CVCC5.2, D1.2, D2.2, D3.2, D4.2, D5.2, H1.1, IC1.6 (GND_1), IC1.9 (GND_2), IC2.6 (GND_1), IC2.9 (GND_2), IC3.6 (GND_1), IC3.9 (GND_2), IC4.6 (GND_1), IC4.9 (GND_2), IC5.6 (GND_1), IC5.9 (GND_2), J2.2, J3.1, RSense1a1.2, RSense1b1.2, RSense2a1.2, RSense2b1.2, RSense3.2, RSense4a1.2, RSense4b1.2, RSense5a1.2, RSense5b1.2
unnamed: CBOOT1.2, IC1.7 (BOOT)
unnamed: IC1.2 (TON), RTON1.2
unnamed: CVCC1.1, IC1.5 (VCC)
unnamed: CBOOT2.2, IC2.7 (BOOT)
unnamed: IC2.2 (TON), RTON2.2
unnamed: CVCC2.1, IC2.5 (VCC)
unnamed: CBOOT3.2, IC3.7 (BOOT)
unnamed: IC3.2 (TON), RTON3.2
unnamed: CVCC3.1, IC3.5 (VCC)
unnamed: CBOOT4.2, IC4.7 (BOOT)
unnamed: IC4.2 (TON), RTON4.2
unnamed: CVCC4.1, IC4.5 (VCC)
unnamed: CBOOT5.2, IC5.7 (BOOT)
unnamed: IC5.2 (TON), RTON5.2
unnamed: CVCC5.1, IC5.5 (VCC)
PWM1: IC1.3 (EN), J1.1, J3.2
PWM2: IC2.3 (EN), J1.2, J3.3
PWM3: IC3.3 (EN), J1.3, J3.4
PWM4: IC4.3 (EN), J1.4, J3.5
PWM5: IC5.3 (EN), J1.5, J3.6

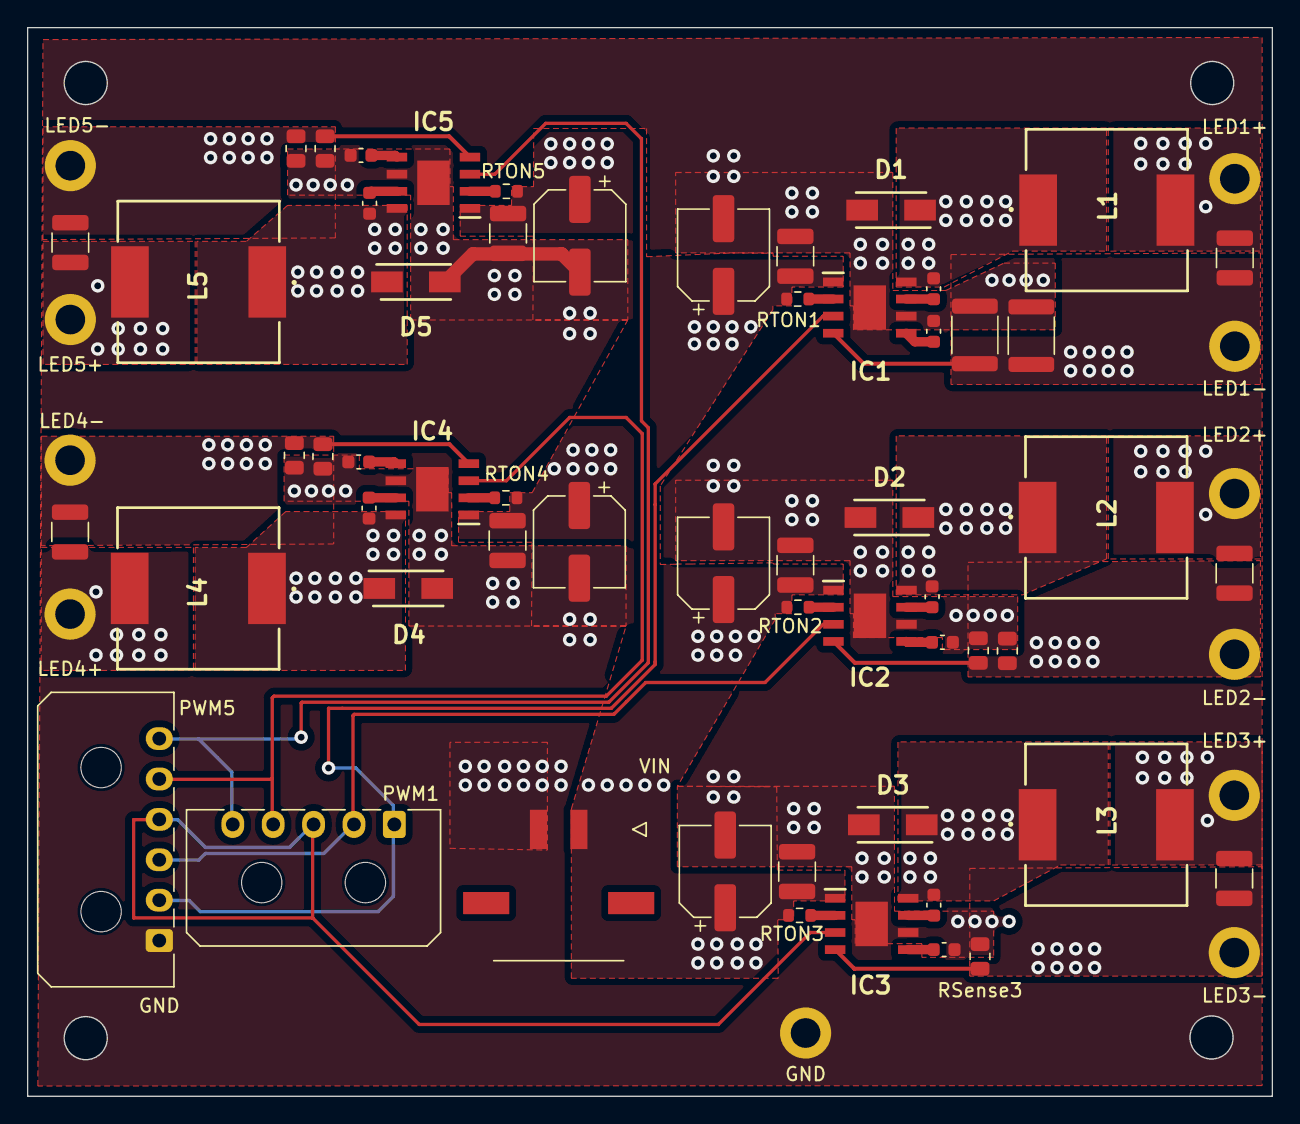
[picture p21: board LayoutDriverPCBv2_3.kicad_pcb from above]

Board: 2 copper layers, 92.5 x 79.4 mm, 68 parts (0 on the bottom side), 37 nets.
